tyler-stowell/RP2040_SMD_Board/Harsch_Systems_RP2040_SMD.kicad_pcb

## KiCad design Harsch_Systems_RP2040_SMD.kicad_pcb (2021-08-09)

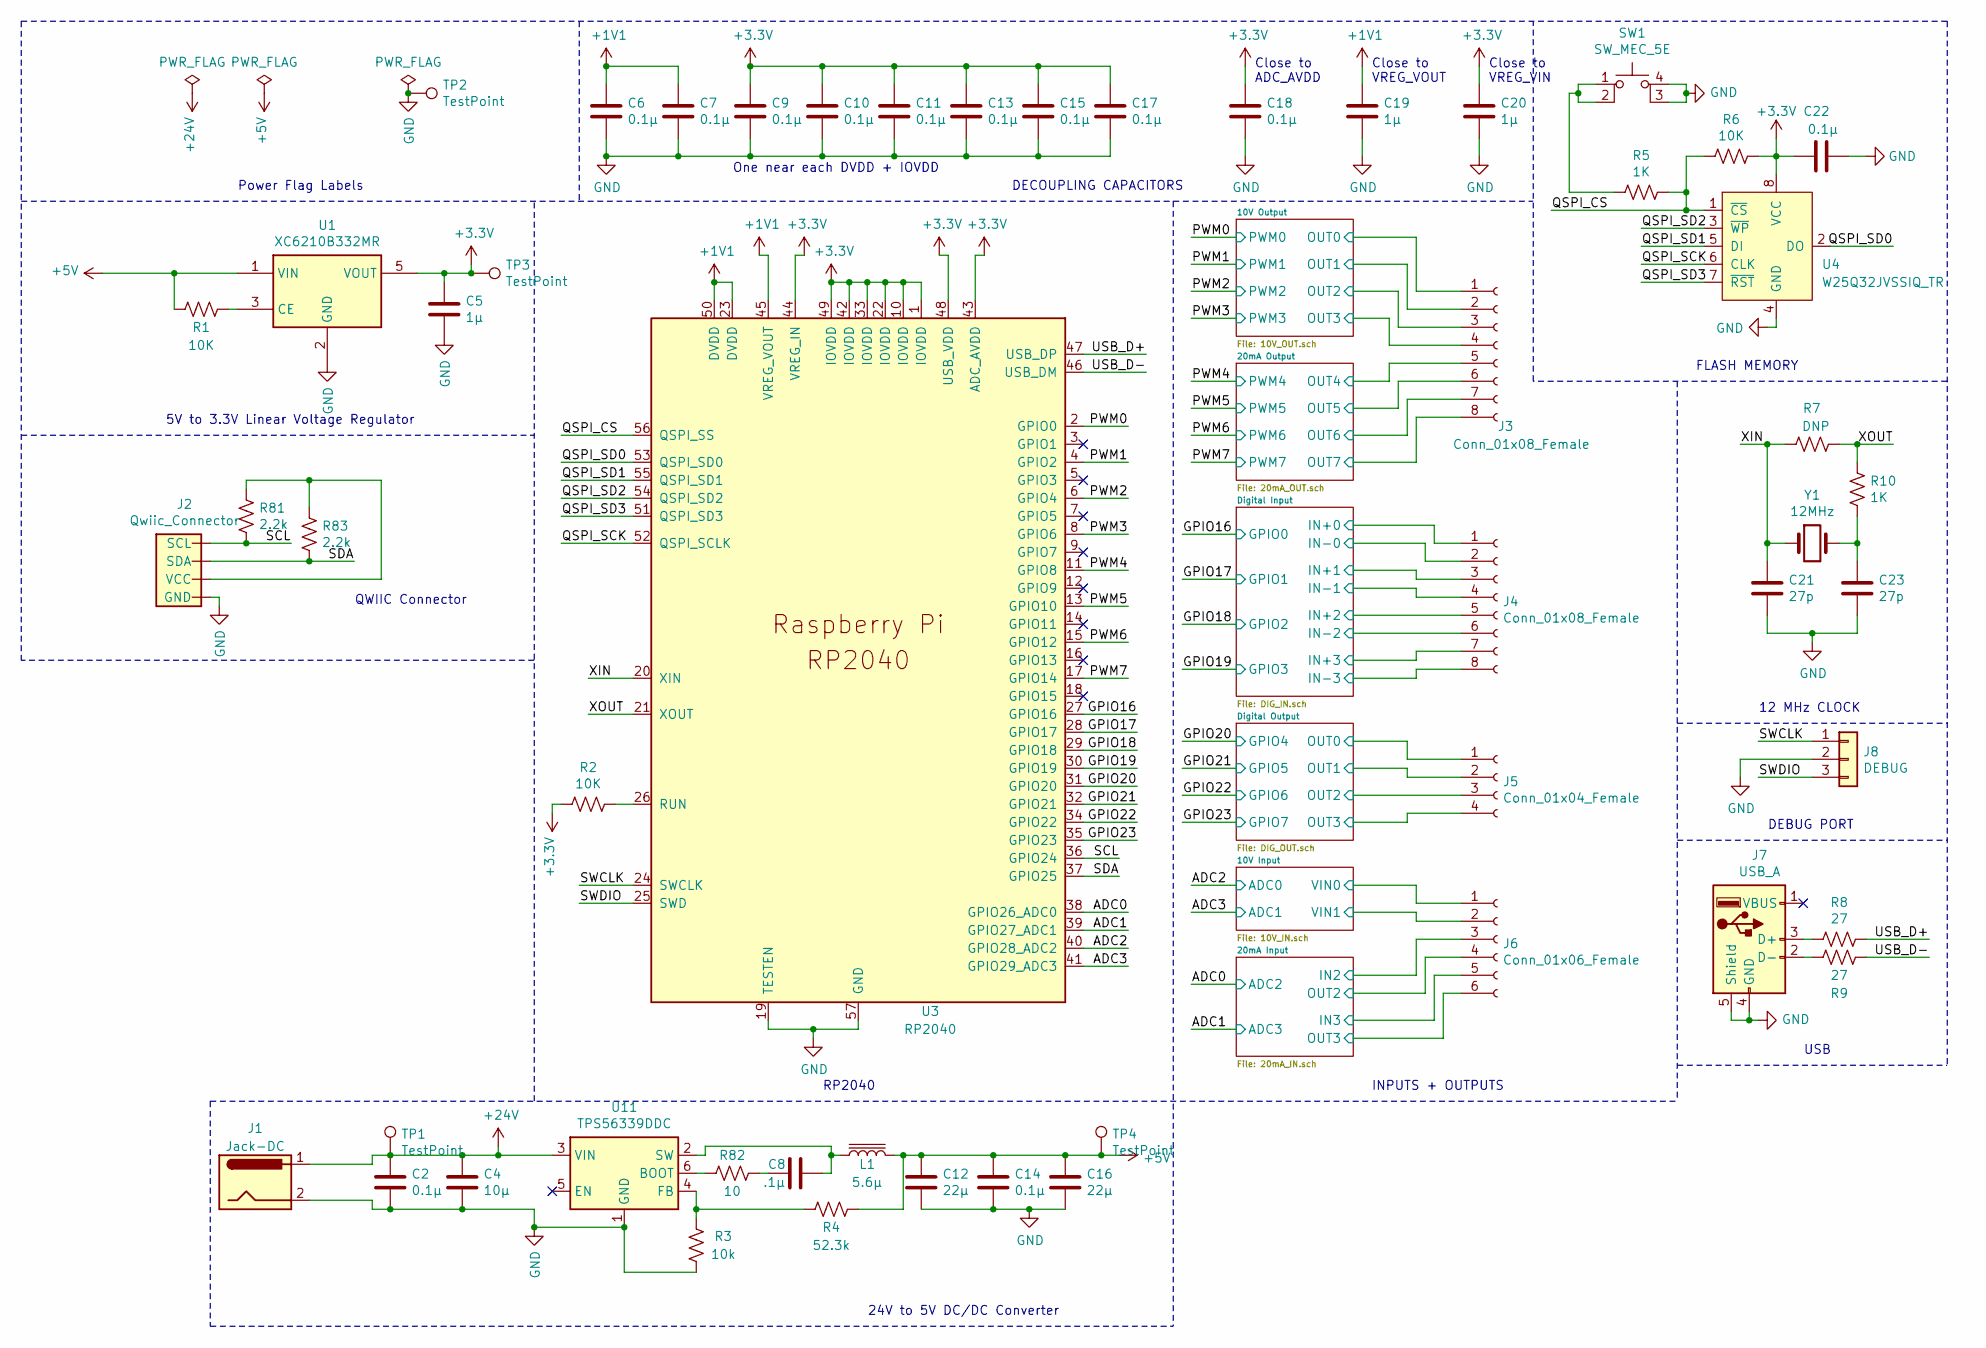
[picture p1: schematic Harsch_Systems_RP2040_SMD.sch]

Parts:
C2, C6, C7, C9, C10, C11, C13, C14, C15, C17, C18, C22: 0.1μ; C_0603_1608Metric
C4: 10μ; C_0805_2012Metric
C5: 1μ; C_0805_2012Metric
C8: .1μ; C_0805_2012Metric
C12, C16: 22μ; C_0805_2012Metric
C19, C20: 1μ; C_0603_1608Metric
C21, C23: 27p; C_0805_2012Metric
J1: Jack-DC; BarrelJack_Horizontal
J2: Qwiic_Connector; 1X04_1MM_RA
J3, J4: Conn_01x08_Female; PinHeader_1x08_P2.54mm_Vertical
J5: Conn_01x04_Female; PinHeader_1x04_P2.54mm_Vertical
J6: Conn_01x06_Female; PinHeader_1x06_P2.54mm_Vertical
J7: USB_A; USB_Micro-B_GCT_USB3076-30-A
J8: DEBUG; PinHeader_1x03_P2.54mm_Vertical
L1: 5.6μ; L_Vishay_IHLP-2020
R1, R2, R6: 10K; R_0805_2012Metric
R3: 10k; R_0805_2012Metric
R4: 52.3k; R_0805_2012Metric
R5, R10: 1K; R_0805_2012Metric
R7: DNP; R_0805_2012Metric
R8, R9: 27; R_0805_2012Metric
R81, R83: 2.2k; R_0805_2012Metric
R82: 10; R_0805_2012Metric
SW1: SW_MEC_5E; SW_SPST_Omron_B3FS-100xP
TP1, TP2, TP3, TP4: TestPoint; PinSocket_1x01_P2.54mm_Vertical
U1: XC6210B332MR; SOT-23-5
U3: RP2040; RP2040-QFN-56
U4: W25Q32JVSSIQ_TR; SOIC-8_W5.6mm; MPN W25Q32JVSSIQ TR; Digi-Key_PN W25Q32JVSSIQCT-ND
U11: TPS56339DDC; SOT-23-6
Y1: 12MHz; Crystal_SMD_0603-2Pin_6.0x3.5mm

Connections:
+1V1: C6.1, C7.1, C19.1, U3.23 (DVDD), U3.45 (VREG_VOUT), U3.50 (DVDD)
+3V3: C5.1, C9.1, C10.1, C11.1, C13.1, C15.1, C17.1, C18.1, C20.1, C22.1, R2.2, R6.1, TP3.1, U1.5 (VOUT), U3.1 (IOVDD), U3.10 (IOVDD), U3.22 (IOVDD), U3.33 (IOVDD), U3.42 (IOVDD), U3.43 (ADC_AVDD), U3.44 (VREG_IN), U3.48 (USB_VDD), U3.49 (IOVDD), U4.8 (VCC); also elsewhere on the board
+5V: C12.1, C14.1, C16.1, L1.2, R1.2, R4.2, TP4.1, U1.1 (VIN); also elsewhere on the board
+24V: C2.1, C4.1, J1.1, TP1.1, U11.3 (VIN); also elsewhere on the board
/10V Input/VIN0: J6.1; also elsewhere on the board
/10V Input/VIN1: J6.2; also elsewhere on the board
/10V Output/OUT0: J3.1; also elsewhere on the board
/10V Output/OUT1: J3.2; also elsewhere on the board
/10V Output/OUT2: J3.3; also elsewhere on the board
/10V Output/OUT3: J3.4; also elsewhere on the board
/20mA Input/IN2: J6.3; also elsewhere on the board
/20mA Input/IN3: J6.5; also elsewhere on the board
/20mA Input/OUT2: J6.4; also elsewhere on the board
/20mA Input/OUT3: J6.6; also elsewhere on the board
/20mA Output/OUT4: J3.5; also elsewhere on the board
/20mA Output/OUT5: J3.6; also elsewhere on the board
/20mA Output/OUT6: J3.7; also elsewhere on the board
/20mA Output/OUT7: J3.8; also elsewhere on the board
/ADC0: U3.38 (GPIO26_ADC0); also elsewhere on the board
/ADC1: U3.39 (GPIO27_ADC1); also elsewhere on the board
/ADC2: U3.40 (GPIO28_ADC2); also elsewhere on the board
/ADC3: U3.41 (GPIO29_ADC3); also elsewhere on the board
/Digital Input/IN+0: J4.1; also elsewhere on the board
/Digital Input/IN+1: J4.3; also elsewhere on the board
/Digital Input/IN+2: J4.5; also elsewhere on the board
/Digital Input/IN+3: J4.7; also elsewhere on the board
/Digital Input/IN-0: J4.2; also elsewhere on the board
/Digital Input/IN-1: J4.4; also elsewhere on the board
/Digital Input/IN-2: J4.6; also elsewhere on the board
/Digital Input/IN-3: J4.8; also elsewhere on the board
/Digital Output/OUT0: J5.1; also elsewhere on the board
/Digital Output/OUT1: J5.2; also elsewhere on the board
/Digital Output/OUT2: J5.3; also elsewhere on the board
/Digital Output/OUT3: J5.4; also elsewhere on the board
/GPIO16: U3.27 (GPIO16); also elsewhere on the board
/GPIO17: U3.28 (GPIO17); also elsewhere on the board
/GPIO18: U3.29 (GPIO18); also elsewhere on the board
/GPIO19: U3.30 (GPIO19); also elsewhere on the board
/GPIO20: U3.31 (GPIO20); also elsewhere on the board
/GPIO21: U3.32 (GPIO21); also elsewhere on the board
/GPIO22: U3.34 (GPIO22); also elsewhere on the board
/GPIO23: U3.35 (GPIO23); also elsewhere on the board
/PWM0: U3.2 (GPIO0); also elsewhere on the board
/PWM1: U3.4 (GPIO2); also elsewhere on the board
/PWM2: U3.6 (GPIO4); also elsewhere on the board
/PWM3: U3.8 (GPIO6); also elsewhere on the board
/PWM4: U3.11 (GPIO8); also elsewhere on the board
/PWM5: U3.13 (GPIO10); also elsewhere on the board
/PWM6: U3.15 (GPIO12); also elsewhere on the board
/PWM7: U3.17 (GPIO14); also elsewhere on the board
/QSPI_CS: R5.1, R6.2, U3.56 (QSPI_SS), U4.1 (~CS)
/QSPI_SCK: U3.52 (QSPI_SCLK), U4.6 (CLK)
/QSPI_SD0: U3.53 (QSPI_SD0), U4.2 (DO)
/QSPI_SD1: U3.55 (QSPI_SD1), U4.5 (DI)
/QSPI_SD2: U3.54 (QSPI_SD2), U4.3 (~WP)
/QSPI_SD3: U3.51 (QSPI_SD3), U4.7 (~RST)
/SCL: J2.4 (SCL), R81.2, U3.36 (GPIO24)
/SDA: J2.3 (SDA), R83.2, U3.37 (GPIO25)
/SWCLK: J8.1, U3.24 (SWCLK)
/SWDIO: J8.3, U3.25 (SWD)
/USB_D+: R8.1, U3.47 (USB_DP)
/USB_D-: R9.1, U3.46 (USB_DM)
/XIN: C21.1, R7.1, U3.20 (XIN), Y1.1
/XOUT: R7.2, R10.1, U3.21 (XOUT)
GND: C2.2, C4.2, C5.2, C6.2, C7.2, C9.2, C10.2, C11.2, C12.2, C13.2, C14.2, C15.2, C16.2, C17.2, C18.2, C19.2, C20.2, C21.2, C22.2, C23.2, J1.2, J2.1 (GND), J7.4 (GND), J7.5 (Shield), J8.2, R3.1, SW1.3 (K), SW1.4 (A), TP2.1, U1.2 (GND), U3.19 (TESTEN), U3.57 (GND), U4.4 (GND), U11.1 (GND); also elsewhere on the board
unnamed: C8.1, R82.1
unnamed: C8.2, L1.1, U11.2 (SW)
unnamed: C23.1, R10.2, Y1.2
unnamed: J2.2 (VCC), R81.1, R83.1
unnamed: J7.2 (D-), R9.2
unnamed: J7.3 (D+), R8.2
unnamed: R1.1, U1.3 (CE)
unnamed: R2.1, U3.26 (RUN)
unnamed: R3.2, R4.1, U11.4 (FB)
unnamed: R5.2, SW1.1, SW1.2
unnamed: R82.2, U11.6 (BOOT)

Notes on the sheet:
One near each DVDD + IOVDD
Close to ADC_AVDD
Close to VREG_VOUT
Close to VREG_VIN
DEBUG PORT
12 MHz CLOCK
FLASH MEMORY
USB
INPUTS + OUTPUTS
DECOUPLING CAPACITORS
RP2040
24V to 5V DC/DC Converter
Power Flag Labels
5V to 3.3V Linear Voltage Regulator
QWIIC Connector

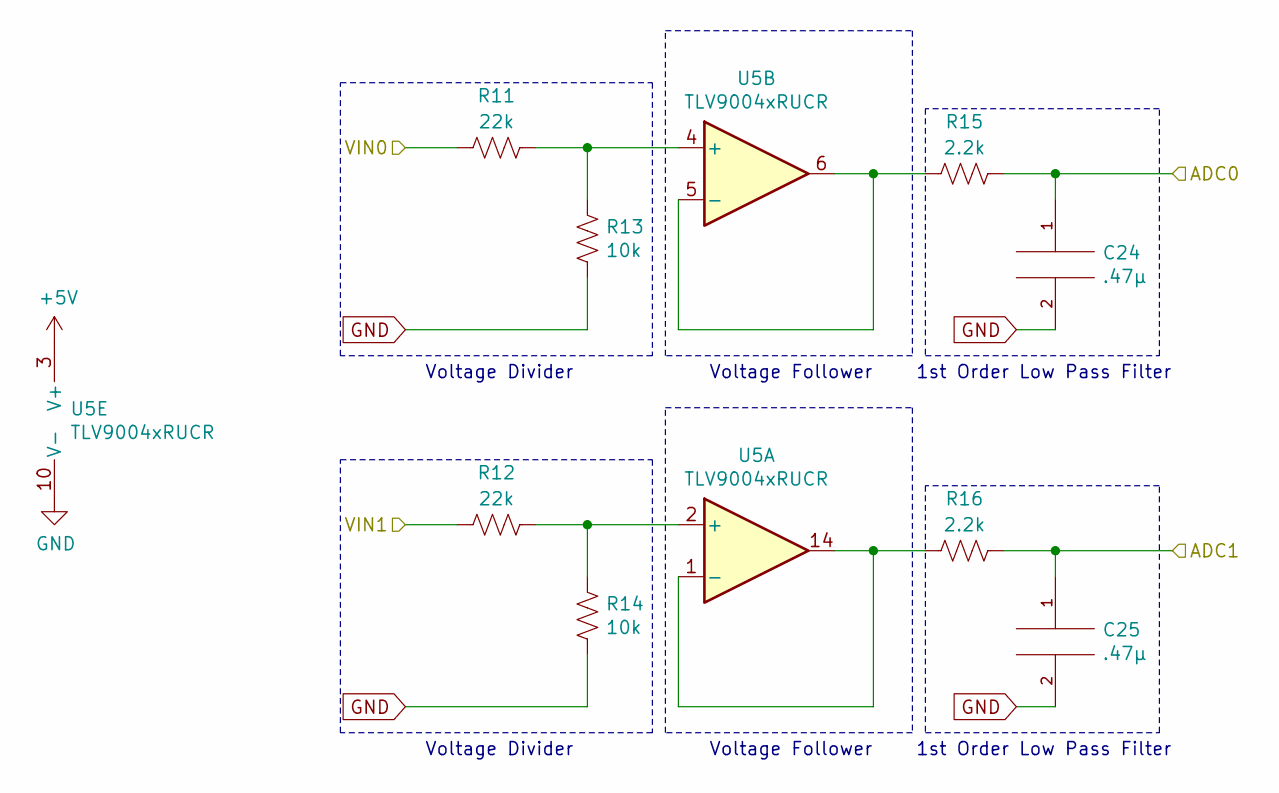
[picture p2: schematic 10V_IN.sch, 10V to 3.3V Input]

Parts:
C24, C25: .47μ; C_0805_2012Metric
R11, R12: 22k; R_0805_2012Metric
R13, R14: 10k; R_0805_2012Metric
R15, R16: 2.2k; R_0805_2012Metric
U5: TLV9004xRUCR; SOIC-14_3.9x8.7mm_P1.27mm

Connections:
+5V: U5.3 (V+); also elsewhere on the board
/10V Input/VIN0: R11.2; also elsewhere on the board
/10V Input/VIN1: R12.2; also elsewhere on the board
/ADC2: C24.1, R15.1; also elsewhere on the board
/ADC3: C25.1, R16.1; also elsewhere on the board
GND: C24.2, C25.2, R13.1, R14.1, U5.10 (V-); also elsewhere on the board
unnamed: R11.1, R13.2, U5.4 (+)
unnamed: R12.1, R14.2, U5.2 (+)
unnamed: R15.2, U5.5 (-), U5.6
unnamed: R16.2, U5.1 (-), U5.14

Notes on the sheet:
Voltage Divider
Voltage Follower
1st Order Low Pass Filter

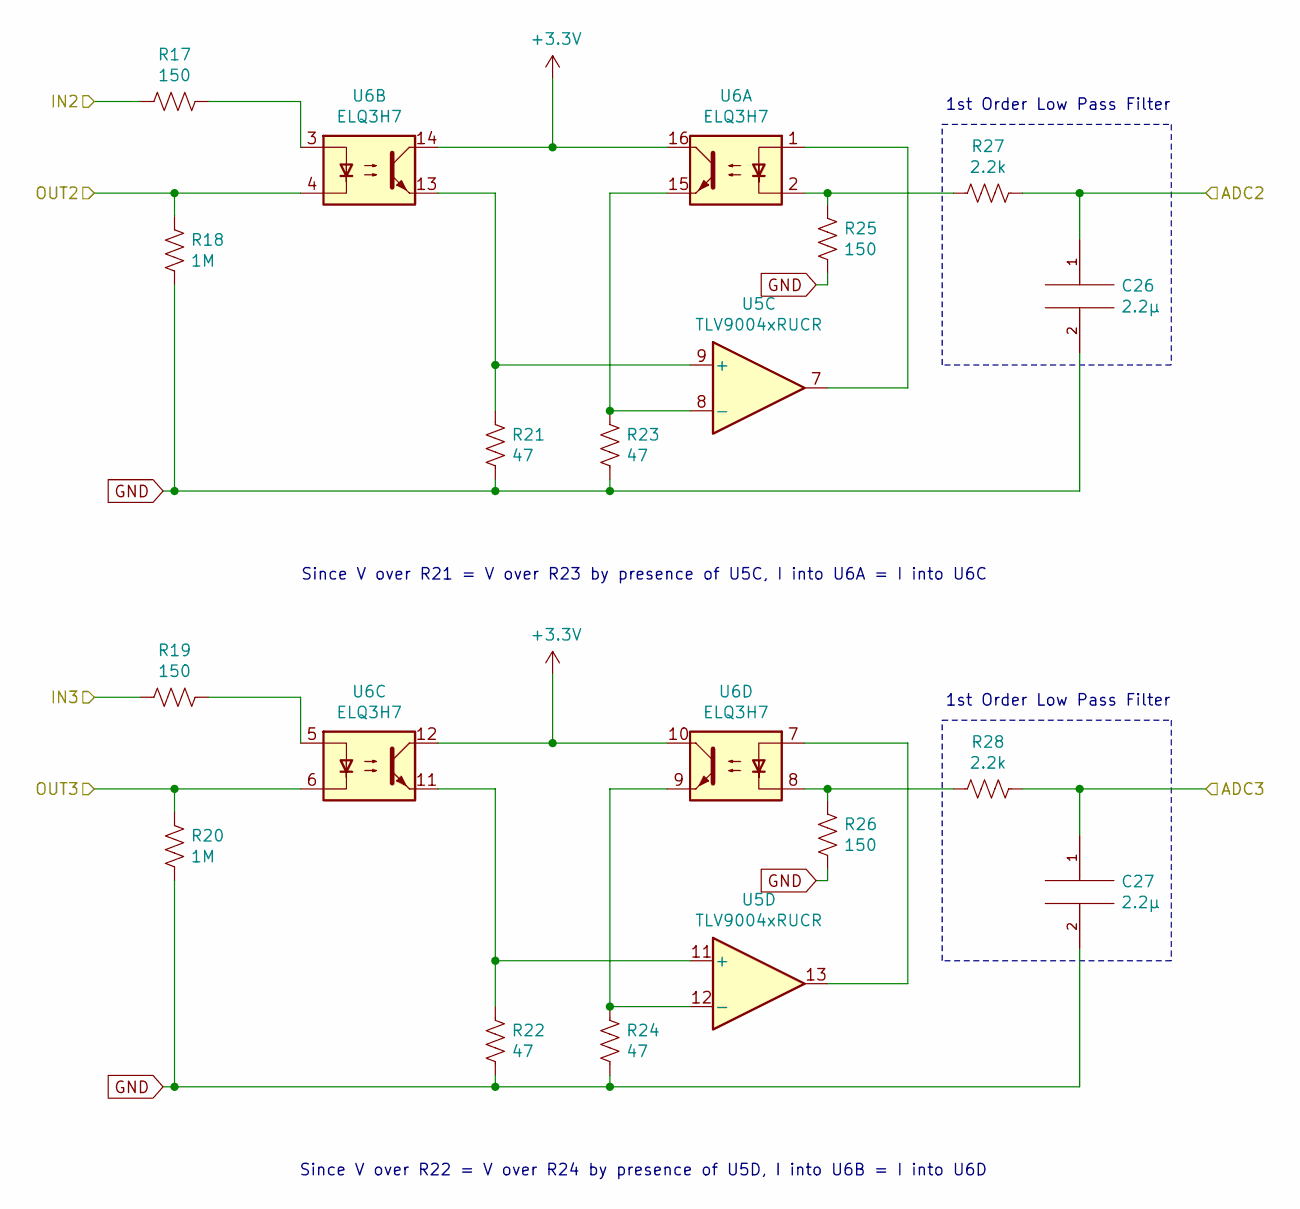
[picture p3: schematic 20mA_IN.sch, 20mA to 3.3V Input]

Parts:
C26, C27: 2.2µ; C_0805_2012Metric
R17, R19, R25, R26: 150; R_0805_2012Metric
R18, R20: 1M; R_0805_2012Metric
R21, R22, R23, R24: 47; R_1210_3225Metric
R27, R28: 2.2k; R_0805_2012Metric
U5: TLV9004xRUCR; SOIC-14_3.9x8.7mm_P1.27mm
U6: ELQ3H7; SOP-16_3.9x9.9mm_P1.27mm

Connections:
+3V3: U6.10, U6.12, U6.14, U6.16; also elsewhere on the board
/20mA Input/IN2: R17.2; also elsewhere on the board
/20mA Input/IN3: R19.2; also elsewhere on the board
/20mA Input/OUT2: R18.2, U6.4; also elsewhere on the board
/20mA Input/OUT3: R20.2, U6.6; also elsewhere on the board
/ADC0: C26.1, R27.1; also elsewhere on the board
/ADC1: C27.1, R28.1; also elsewhere on the board
GND: C26.2, C27.2, R18.1, R20.1, R21.1, R22.1, R23.1, R24.1, R25.1, R26.1; also elsewhere on the board
unnamed: R17.1, U6.3
unnamed: R19.1, U6.5
unnamed: R21.2, U5.9 (+), U6.13
unnamed: R22.2, U5.11 (+), U6.11
unnamed: R23.2, U5.8 (-), U6.15
unnamed: R24.2, U5.12 (-), U6.9
unnamed: R25.2, R27.2, U6.2
unnamed: R26.2, R28.2, U6.8
unnamed: U5.7, U6.1
unnamed: U5.13, U6.7

Notes on the sheet:
1st Order Low Pass Filter
Since V over R22 = V over R24 by presence of U5D, I into U6B = I into U6D
Since V over R21 = V over R23 by presence of U5C, I into U6A = I into U6C

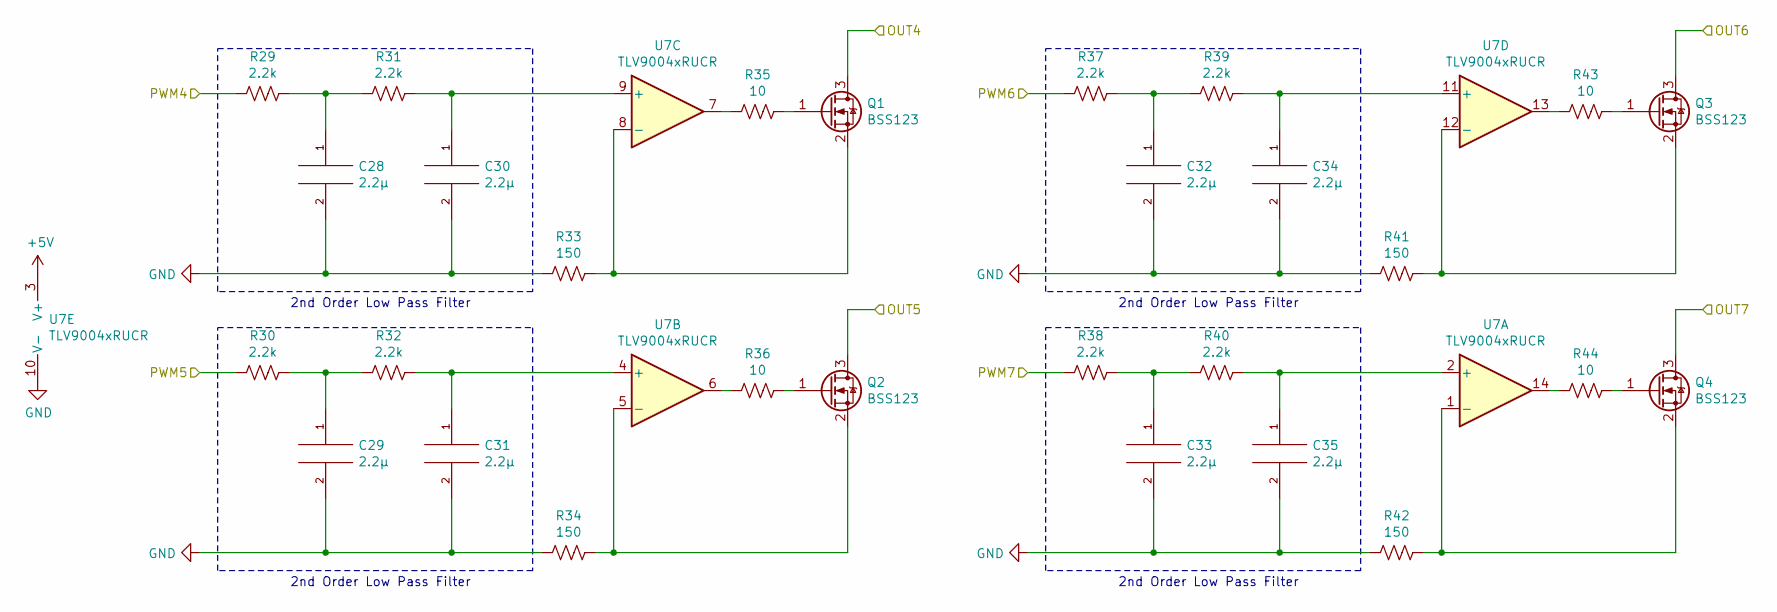
[picture p4: schematic 20mA_OUT.sch, PWM to 20mA Output]

Parts:
C28, C29, C30, C31, C32, C33, C34, C35: 2.2μ; C_0805_2012Metric
Q1, Q2, Q3, Q4: BSS123; SOT-23
R29, R30, R31, R32, R37, R38, R39, R40: 2.2k; R_0805_2012Metric
R33, R34, R41, R42: 150; R_0805_2012Metric
R35, R36, R43, R44: 10; R_0805_2012Metric
U7: TLV9004xRUCR; SOIC-14_3.9x8.7mm_P1.27mm

Connections:
+5V: U7.3 (V+); also elsewhere on the board
/20mA Output/OUT4: Q1.3 (D); also elsewhere on the board
/20mA Output/OUT5: Q2.3 (D); also elsewhere on the board
/20mA Output/OUT6: Q3.3 (D); also elsewhere on the board
/20mA Output/OUT7: Q4.3 (D); also elsewhere on the board
/PWM4: R29.2; also elsewhere on the board
/PWM5: R30.2; also elsewhere on the board
/PWM6: R37.2; also elsewhere on the board
/PWM7: R38.2; also elsewhere on the board
GND: C28.2, C29.2, C30.2, C31.2, C32.2, C33.2, C34.2, C35.2, R33.2, R34.2, R41.2, R42.2, U7.10 (V-); also elsewhere on the board
unnamed: C28.1, R29.1, R31.2
unnamed: C29.1, R30.1, R32.2
unnamed: C30.1, R31.1, U7.9 (+)
unnamed: C31.1, R32.1, U7.4 (+)
unnamed: C32.1, R37.1, R39.2
unnamed: C33.1, R38.1, R40.2
unnamed: C34.1, R39.1, U7.11 (+)
unnamed: C35.1, R40.1, U7.2 (+)
unnamed: Q1.1 (G), R35.1
unnamed: Q1.2 (S), R33.1, U7.8 (-)
unnamed: Q2.1 (G), R36.1
unnamed: Q2.2 (S), R34.1, U7.5 (-)
unnamed: Q3.1 (G), R43.1
unnamed: Q3.2 (S), R41.1, U7.12 (-)
unnamed: Q4.1 (G), R44.1
unnamed: Q4.2 (S), R42.1, U7.1 (-)
unnamed: R35.2, U7.7
unnamed: R36.2, U7.6
unnamed: R43.2, U7.13
unnamed: R44.2, U7.14

Notes on the sheet:
2nd Order Low Pass Filter

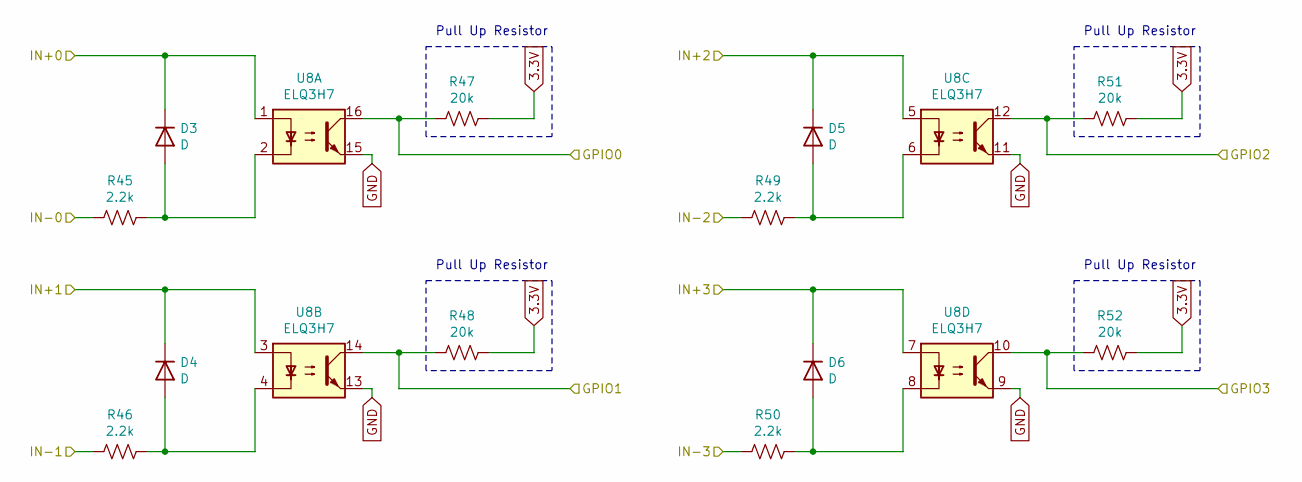
[picture p5: schematic DIG_IN.sch, Digital Input]

Parts:
D3, D4, D5, D6: D; D_0805_2012Metric
R45, R46, R49, R50: 2.2k; R_1210_3225Metric
R47, R48, R51, R52: 20k; R_0805_2012Metric
U8: ELQ3H7; SOP-16_3.9x9.9mm_P1.27mm

Connections:
3.3V: R47.1, R48.1, R51.1, R52.1
/Digital Input/IN+0: D3.1 (K), U8.1; also elsewhere on the board
/Digital Input/IN+1: D4.1 (K), U8.3; also elsewhere on the board
/Digital Input/IN+2: D5.1 (K), U8.5; also elsewhere on the board
/Digital Input/IN+3: D6.1 (K), U8.7; also elsewhere on the board
/Digital Input/IN-0: R45.1; also elsewhere on the board
/Digital Input/IN-1: R46.1; also elsewhere on the board
/Digital Input/IN-2: R49.1; also elsewhere on the board
/Digital Input/IN-3: R50.1; also elsewhere on the board
/GPIO16: R47.2, U8.16; also elsewhere on the board
/GPIO17: R48.2, U8.14; also elsewhere on the board
/GPIO18: R51.2, U8.12; also elsewhere on the board
/GPIO19: R52.2, U8.10; also elsewhere on the board
GND: U8.9, U8.11, U8.13, U8.15; also elsewhere on the board
unnamed: D3.2 (A), R45.2, U8.2
unnamed: D4.2 (A), R46.2, U8.4
unnamed: D5.2 (A), R49.2, U8.6
unnamed: D6.2 (A), R50.2, U8.8

Notes on the sheet:
Pull Up Resistor

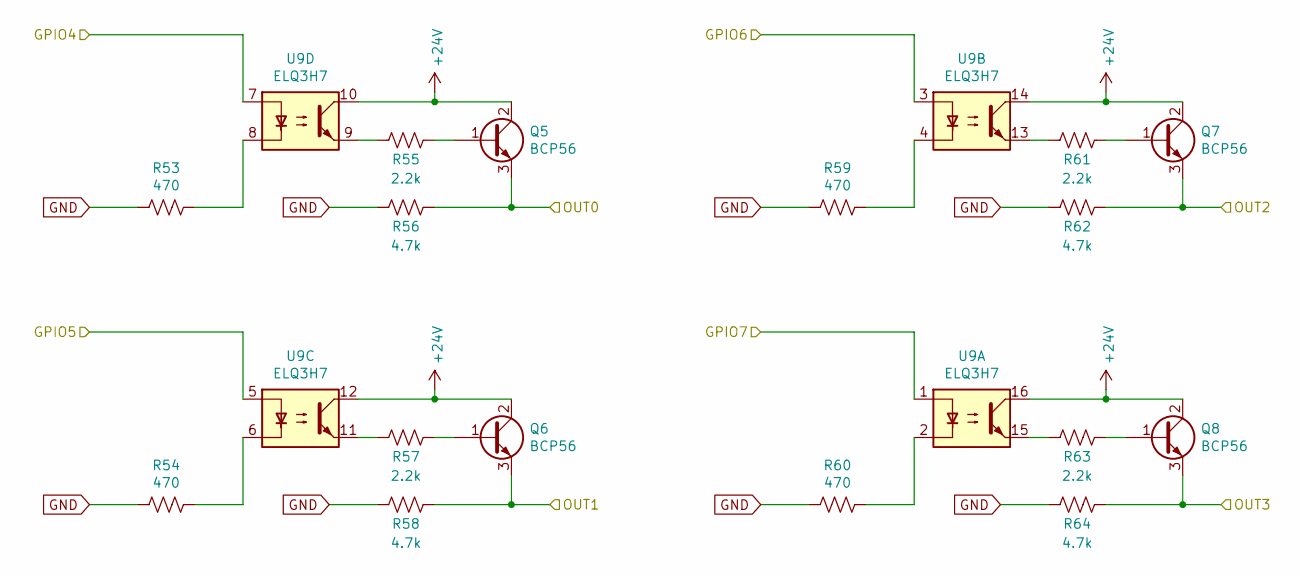
[picture p6: schematic DIG_OUT.sch, Digital Output]

Parts:
Q5, Q6, Q7, Q8: BCP56; SOT-223
R53, R54, R59, R60: 470; R_0805_2012Metric
R55, R57, R61, R63: 2.2k; R_0805_2012Metric
R56, R58, R62, R64: 4.7k; R_0805_2012Metric
U9: ELQ3H7; SOP-16_3.9x9.9mm_P1.27mm

Connections:
+24V: Q5.2 (C), Q5.4 (C), Q6.2 (C), Q6.4 (C), Q7.2 (C), Q7.4 (C), Q8.2 (C), Q8.4 (C), U9.10, U9.12, U9.14, U9.16; also elsewhere on the board
/Digital Output/OUT0: Q5.3 (E), R56.2; also elsewhere on the board
/Digital Output/OUT1: Q6.3 (E), R58.2; also elsewhere on the board
/Digital Output/OUT2: Q7.3 (E), R62.2; also elsewhere on the board
/Digital Output/OUT3: Q8.3 (E), R64.2; also elsewhere on the board
/GPIO20: U9.7; also elsewhere on the board
/GPIO21: U9.5; also elsewhere on the board
/GPIO22: U9.3; also elsewhere on the board
/GPIO23: U9.1; also elsewhere on the board
GND: R53.1, R54.1, R56.1, R58.1, R59.1, R60.1, R62.1, R64.1; also elsewhere on the board
unnamed: Q5.1 (B), R55.2
unnamed: Q6.1 (B), R57.2
unnamed: Q7.1 (B), R61.2
unnamed: Q8.1 (B), R63.2
unnamed: R53.2, U9.8
unnamed: R54.2, U9.6
unnamed: R55.1, U9.9
unnamed: R57.1, U9.11
unnamed: R59.2, U9.4
unnamed: R60.2, U9.2
unnamed: R61.1, U9.13
unnamed: R63.1, U9.15

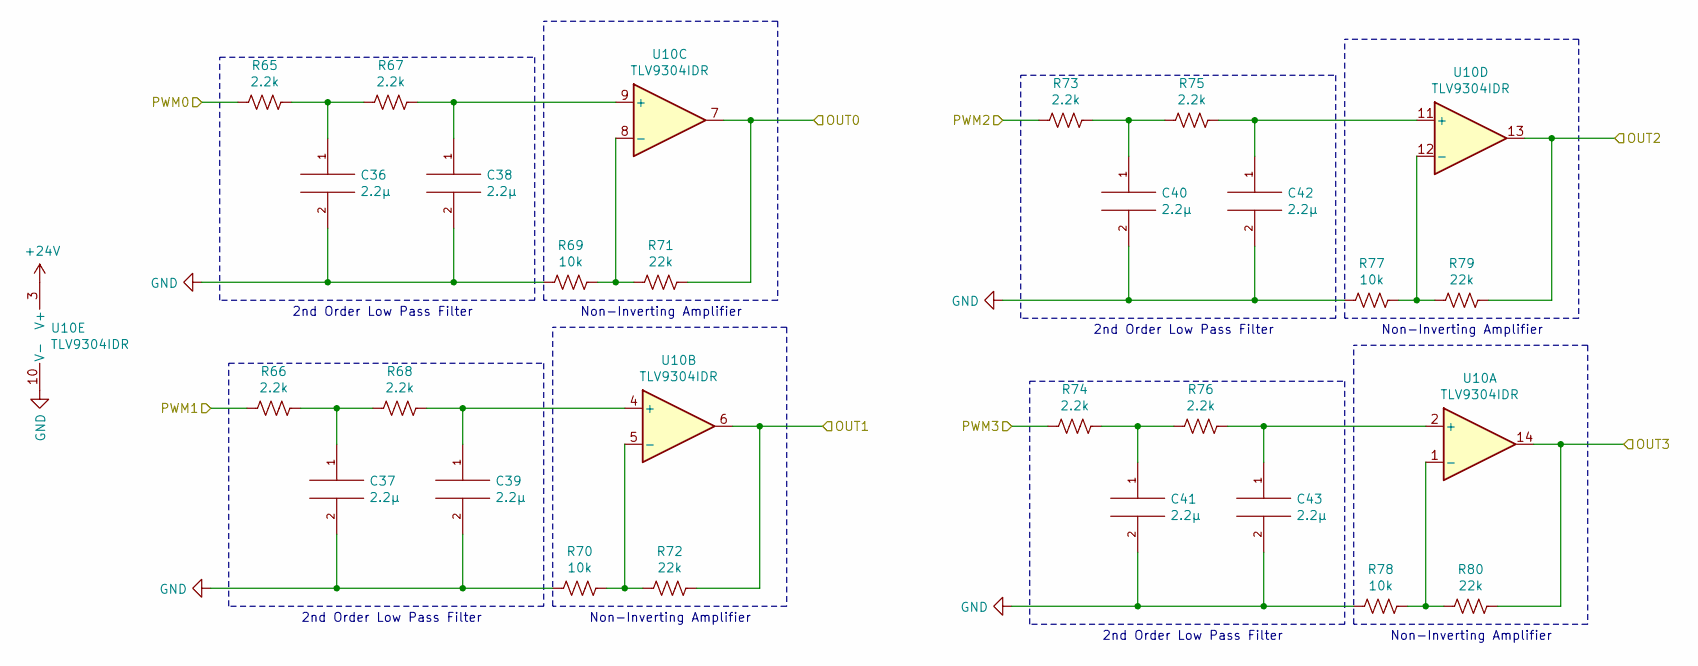
[picture p7: schematic 10V_OUT.sch, PWM to 10 V Output]

Parts:
C36, C37, C38, C39, C40, C41, C42, C43: 2.2μ; C_0805_2012Metric
R65, R66, R67, R68, R73, R74, R75, R76: 2.2k; R_0805_2012Metric
R69, R70, R77, R78: 10k; R_0805_2012Metric
R71, R72, R79, R80: 22k; R_0805_2012Metric
U10: TLV9304IDR; SOIC-14_3.9x8.7mm_P1.27mm

Connections:
+24V: U10.3 (V+); also elsewhere on the board
/10V Output/OUT0: R71.1, U10.7; also elsewhere on the board
/10V Output/OUT1: R72.1, U10.6; also elsewhere on the board
/10V Output/OUT2: R79.1, U10.13; also elsewhere on the board
/10V Output/OUT3: R80.1, U10.14; also elsewhere on the board
/PWM0: R65.2; also elsewhere on the board
/PWM1: R66.2; also elsewhere on the board
/PWM2: R73.2; also elsewhere on the board
/PWM3: R74.2; also elsewhere on the board
GND: C36.2, C37.2, C38.2, C39.2, C40.2, C41.2, C42.2, C43.2, R69.2, R70.2, R77.2, R78.2, U10.10 (V-); also elsewhere on the board
unnamed: C36.1, R65.1, R67.2
unnamed: C37.1, R66.1, R68.2
unnamed: C38.1, R67.1, U10.9 (+)
unnamed: C39.1, R68.1, U10.4 (+)
unnamed: C40.1, R73.1, R75.2
unnamed: C41.1, R74.1, R76.2
unnamed: C42.1, R75.1, U10.11 (+)
unnamed: C43.1, R76.1, U10.2 (+)
unnamed: R69.1, R71.2, U10.8 (-)
unnamed: R70.1, R72.2, U10.5 (-)
unnamed: R77.1, R79.2, U10.12 (-)
unnamed: R78.1, R80.2, U10.1 (-)

Notes on the sheet:
2nd Order Low Pass Filter
Non-Inverting Amplifier

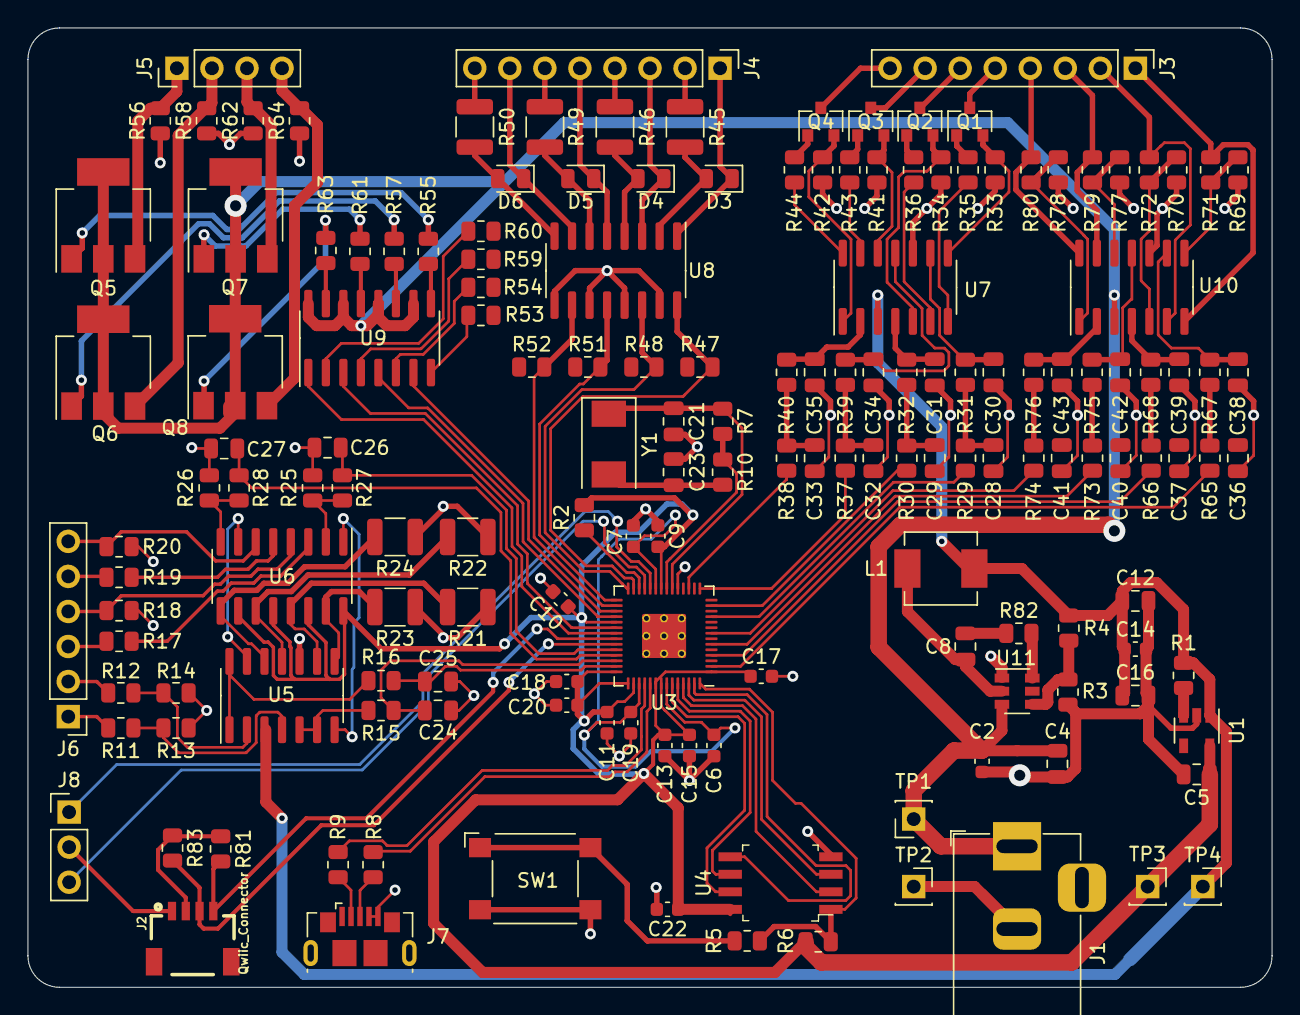
[picture p8: board Harsch_Systems_RP2040_SMD.kicad_pcb from above]

Board: 2 copper layers, 90.2 x 69.5 mm, 161 parts (0 on the bottom side), 139 nets.
