tyler-stowell/RP2040_SMD_Board/(commit log)

2021-07-19 Initial commit of SMD based RP2040 industrial board
    [10V_IN.sch, 10V_OUT.sch, 20mA_IN.sch, 20mA_OUT.sch, DIG_IN.sch, DIG_OUT.sch, Harsch_Systems_RP2040_SMD.kicad_pcb, Harsch_Systems_RP2040_SMD.sch]
2021-07-22 Updates, cleanup, and component association.
    [10V_IN.sch, Harsch_Systems_RP2040_SMD.sch]
2021-07-23 Starting routing
    [Harsch_Systems_RP2040_SMD.kicad_pcb, Harsch_Systems_RP2040_SMD.sch]
2021-07-24 Finished the schematic, except for maybe a couple test points.
    [10V_IN.sch, 10V_OUT.sch, 20mA_IN.sch, 20mA_OUT.sch, DIG_IN.sch, DIG_OUT.sch, Harsch_Systems_RP2040_SMD.kicad_pcb, Harsch_Systems_RP2040_SMD.sch]
2021-08-04 Routing for all analog outputs
    [10V_OUT.sch, 20mA_OUT.sch, Harsch_Systems_RP2040_SMD.kicad_pcb]
2021-08-05 Routed ADC inputs and adjusted some trace widths
    [10V_IN.sch, 20mA_IN.sch, Harsch_Systems_RP2040_SMD.kicad_pcb]
2021-08-05 Power circuitry routing and board outline
    [Harsch_Systems_RP2040_SMD.kicad_pcb, Harsch_Systems_RP2040_SMD.sch]
2021-08-06 Everything but the 24V output is routed
    [20mA_IN.sch, DIG_OUT.sch, Harsch_Systems_RP2040_SMD.kicad_pcb, Harsch_Systems_RP2040_SMD.sch]
2021-08-06 Finished routing, but realized an optocoupler on 24V outputs isn't rated high enough
    [Harsch_Systems_RP2040_SMD.kicad_pcb]
2021-08-06 Re-added mounting holes, fixed a small issue
    [Harsch_Systems_RP2040_SMD.kicad_pcb]
2021-08-09 Adjusted some tracks and vias for better heat dissipation
    [20mA_IN.sch, Harsch_Systems_RP2040_SMD.kicad_pcb, Harsch_Systems_RP2040_SMD.sch]
2021-08-09 Added an I2C QWIIC Connector
    [Harsch_Systems_RP2040_SMD.kicad_pcb, Harsch_Systems_RP2040_SMD.sch]
